ZG-untitled/fpga-environment-sound-recognition/mechanical/README.md

# Mechanical Files

- `enclosure/` contains the enclosure design note and six panel models in 3MF and STL formats, supplied by teammate C.
- `microphone_plate/` contains the microphone plate generator and the supplied STL exports.
- `../docs/images/interface/interface.png` is the supplied interface screenshot.

The 3MF files are editable slicer/project files; STL files are mesh exports for inspection or printing. Confirm fit and print settings against the physical board and screen before manufacturing.
