ZG-untitled/fpga-environment-sound-recognition/mechanical/enclosure/外壳设计方案.md

# 作品外壳设计方案（六片分体版）

> 版本 v9（2026-10-29）· 丙（PS/整机负责人）
> 形态：**桌面横屏告警终端**，六片平放打印后拼装
> 本版替代并作废 v1「壁挂式 210×235×55」方案
>
> **v9 变更**：
> ① 屏幕开窗 **171×104 → 166×102**，位置 **z 8~110**。原来是"比玻璃大一圈"（左右缝 3.1、上下缝 2），
> 玻璃在窗口里晃、正面能看见缝隙；现在改成"**刚好托住玻璃**"：玻璃 164.8×100 距底座下边实测 **4.0**，
> 所以窗下沿放在 **z 8**，与玻璃下边**齐平**（窗下沿余料 2 → **4**），窗口横向只比玻璃大 **0.6**，
> 玻璃卡进窗孔、下边缘落在窗框上。副作用（正面收益）：4 个 Φ3.2 孔心 x 16.7 / 191.3
> 全部落到窗框后面，正看**不再露孔**。
> ② 灯带进线孔宽 3 → **4.5**（灯带端头是 **2.54-3P 杜邦胶壳**，厚 2.54~
> 2.6；原 3.0 单边仅余 0.23 mm，胶壳侧边锁扣再加一点就过不去）
>
> **v8 变更**：外廓 200→**208**（用户实测：串口屏排线从**屏幕左侧**引出，需侧向走线空间，
> 内腔留 200，模组 181 居中后左右净空各 9.5）；屏幕开窗 165.5×100.5 → **171×104**
> （横向受螺丝孔距 174.6 约束，上限 171.4，取 171 使 4×Φ3.2 孔全部被窗框挡住）；
> 后盖出口槽随右板内表面右移 8 → x 135~190
>
> v7：外廓 192→200；开窗 155×99 → 165.5×100.5；灯带进线孔 φ8 → 3×11 竖长方孔

---

## 一、器件尺寸（设计依据）

| 部件 | 尺寸（mm） | 说明 |
|---|---|---|
| 8 寸串口屏 8048AS048 | PCB 181×108（横放）；**LCD 模组 164.9×100（开窗依据）**；AA 154.08×85.92；厚 6.15；4×Φ3.2，孔距 **174.6 × 101.6** | 横放 |
| 启明星 ZYNQ-7020 底板 | **130×100**，板堆叠总高 **7.7**（含 1.6 PCB） | 平放 |
| INMP441 麦克风 | 4 只，2×2，孔距 **60×60**；沉孔 φ14.7×2.0 + 通孔 φ12.4 | 并入顶板 |
| WS2812 灯带 | **500 mm / 30 灯 / 宽 10** | 绕四周 |

---

## 二、总体尺寸

**208 (W) × 120 (D) × 140 (H)，壁厚 4，直角**

| 项 | 数值 |
|---|---|
| 内腔 | **192** × 112 × 132 |
| 屏幕模组 | 181 × 108，宽度方向居中（x 13.5~194.5），**底部贴底板内表面**（z 4~112）；玻璃 164.8×100 **距底座下边 4.0（实测）** → 落在 z 8~108，下边与窗下沿 z 8 齐平 |
| 屏幕窗 | **166 × 102**，x 21~187，z **8~110**（左右各留 21、下方 **4**、上方 26）；玻璃 164.8×100 距底座下边 4.0，下边与窗下沿齐平，横向缝 0.6 |
| 灯带槽 | z 121~132（宽 11）、深 1.5，绕前/后/左/右四周，中心线周长 **612** |
| 灯带进线孔 | **4.5(宽) × 11(高) 竖长方孔**，x 51.75~56.25，z 121~132，穿后壁 2.5，**距灯带左端头 3.75** |
| 麦克风 | 4×（沉孔 φ14.7 深 2 + 通孔 φ12.4），孔心 **(70,30)(130,30)(70,90)(130,90)** |
| 后盖出口 | 跑道形 55 × 20（R10），**x 135~190**，**z 12~32** |
| 开发板支撑 | M3 铜柱 **13**，DC 座插孔中心距箱底 **20**（实测） |
| 深度链 | 面板 4 + 屏 6.15 + 间隙 3.85 + 开发板 100 + 间隙 2 + 后盖 4 = 120 |

**为什么宽度是 208**：屏幕模组 181 宽横放，**排线从屏幕左侧引出**，左侧必须留出侧向走线空间。
内腔留 200（W=208），模组居中后左右净空各 **9.5**，左侧 9.5 足够 FPC 反折一次。
**为什么开窗是 166×102、z 8~110（v9 改小，不再"加大"）**：玻璃 164.8×100，模组 181×108。
窗口横向只比玻璃大 **0.6**，玻璃直接卡进窗孔 → 屏幕被窗框箍住不晃，正面缝隙从 3.1 降到 0.6。
三条硬约束同时满足：
① 螺丝孔 x 16.7 / 191.3（孔距 174.6）落在窗口 x 21~187 之外 → **不再露孔**
（v8 的 171 已刚好挡住，173 就会露出 0.8）；
② AA 区 154.08×85.92 距窗口边 5.96 / 8.04，**遮的只是黑边框，不切显示内容**；
③ **下沿与玻璃下边齐平**：玻璃距底座下边实测 **4.0**（模组 z 4~112 → 玻璃 z 8~108），
所以窗下沿放在 **z 8**，窗下沿余料 = 8 − 4 = **4**（v8 只有 2，用户指出太细）。
上沿 z 110 比玻璃上边 108 高 2，留装配余量。
（此前 v9 初稿把下沿放在 z 7、余 3，是因为把"4"只当成居中假设；用户拿卡尺在模型上量出 3 才纠正）

**为什么深度还是 120**：屏幕只占 6.15 厚，深度方向的约束来自开发板平放的 100 长 + DC 插头，与屏幕无关，故不动。

**为什么深度是 120**：开发板平放（不是立放）。立放时内高 132 只剩 2 mm 余量，而 DC 座那条边只能朝上、插头后 30 mm 硬护套无处可去，顶面又是麦克风板不能开槽——立放不可行。平放后插头从后盖孔穿出，硬护套留在壳外。

**DC 座高度决定铜柱**：实测插孔中心距箱底（放桌上即桌面）**20**。座体自身只能提供 7.1（PCB 顶面算起 5.5 + 板厚 1.6），所以铜柱必须垫到 **13**（M3×13 标准件）。

插头 φ12 占 z 14~26，JTAG 排线扭平后在其上方 z 28~31，故出口槽取 **z 12~32**：下端余 2、上端余 6。注意这是**偏心使用**——槽中心是 22，不是 20，高的那 6 mm 是留给排线的。

---

## 三、六片尺寸

| 片 | 外形（mm） | 内容 |
|---|---|---|
| `panel_front` 前面板 | **208** × 132 × 4 | 屏幕窗、灯带槽、上/下各 6 齿、左右竖棱舌槽 |
| `panel_back` 后面板 | **208** × 132 × 4 | 出口槽 55×20、灯带槽、上/下各 6 齿、竖棱舌槽 |
| `panel_left` 左板 | 4 × 112 × 132 | 灯带槽、上/下各 3 齿、前后两端伸舌 |
| `panel_right` 右板 | 4 × 112 × 132 | 同上（镜像） |
| `panel_top` 顶板 | **208** × 120 × 4 | 4×麦克风沉孔+通孔、18 个齿槽 |
| `panel_bottom` 底板 | **208** × 120 × 4 | 18 个齿槽 |

---

## 四、齿接参数

| 项 | 数值 | 说明 |
|---|---|---|
| 齿宽 | **7.8** | 槽 8.2，单边间隙 0.2 |
| 齿长 | **2.5** | 槽深 2.7，槽底留 1.3 料 |
| 前/后面板上下边 | 齿区**居中 96**，6 齿 | 两端各 48 平直 |
| 左/右板上边 | 齿区**居中 48**，3 齿 | 两端各 32 平直 |
| 竖棱 | 沿 Z **舌槽**，深 2 | z 10~110，避开灯带槽 |

**两条硬约束（不是省事）：**

1. **竖棱不能做齿。** 齿要咬合必须沿齿轴相对平移：前面板上齿齿轴是 Z（整板上下压），竖边齿轴是 X（整板左右移），一块板只有一条运动路线。所以竖棱只能是沿 Z 通长的舌槽，压入时顺槽滑合。

2. **齿长只能 2.5，不能 3.9。** 原本想让齿穿过 4 厚壁、外表面留 0.1 微凹。但 FDM 层高 0.2，0.1 的余量保不住，实际会顶穿或留缝。改 2.5/2.7 后槽底留 1.3，安全。

**为什么齿集中在中段**：指接不要求齿铺满整边，只要两片齿区对齐、其余平直段自然对上。集中后 ① 齿宽回到 7.8（铺满 192 会变成 17.5 的宽扁块）② 角部三面交角冲突自动消失 ③ 装配只需对准中段，抗打印误差。

---

## 五、装配顺序

1. **四墙沿 Z 拼合**：前面板 + 后面板平放定位，左板/右板沿 Z 滑入，舌进槽
2. **顶板从上压**：18 个齿槽同时套入四墙上齿
3. **翻面，底板压入**
4. 接缝点胶；灯带压在最上方接缝外侧补强

**注意**：顶板压合后基本不可拆。核心板、JTAG、SD 卡需在压合前操作完毕；调试期可先不上胶。

---

## 六、打印参数

**总原则：让每一片的所有凹槽"开口朝上"。** 开口朝上的槽是逐层向内收的坑，槽底直接落在已成型的实心材料上；开口朝下的槽是悬挑，只能靠桥接硬拉，必然下垂拉丝——这正是后盖舌槽粗糙的成因。

| 片 | 摆向 | 贴床面 | 凹槽开口 | 桥接 / 支撑 |
|---|---|---|---|---|
| 前面板 | 平放 | **内表面**（外表面朝上） | 灯带槽 11×1.5 朝上 ✓ | 仅竖棱舌槽 4 宽朝下，桥接 4 mm；**无支撑** |
| 左 / 右板 | 平放 | **内表面**（整面无槽） | 灯带槽 11×1.5 朝上 ✓ | **完全无桥接、无支撑** |
| 顶板 | 平放 | **外表面**（内表面朝上） | 18 个齿槽 8.2×2.7 朝上 ✓ | 沉孔朝下只剩 1.15 宽圆环桥接；**无支撑** |
| 底板 | 平放 | 外表面（已全平） | 18 个齿槽 8.2×2.7 朝上 ✓ | **完全无桥接、无支撑** |
| 后面板 | 已打印完成 | — | — | 不参与本轮 |

**为什么前面板/侧板从"外表面朝下"改成"内表面朝下"**：灯带槽开在外表面。外表面朝下时槽口朝下，槽底要跨 11 mm 悬空桥接；改内表面朝下，灯带槽口朝上，槽底变成实心支撑。代价仅是竖棱舌槽（4 宽）朝下桥接 4 mm，PLA 毫无压力。

**为什么顶板必须"外表面朝下"**：齿槽开在内表面。外表面朝上时 18 个齿槽开口朝下、槽底在 y=0 一端还没有锚点，是悬挑，会大面积下垂，18 个槽全部失准——这是本方案里唯一不能妥协的一处。代价是白色顶面贴床（得纹理面）＋沉孔口需象脚补偿。

**切片参数（已写入 5 个 3mf）**

| 参数 | 旧 | 新 | 原因 |
|---|---|---|---|
| 稀疏填充密度 | 15% | **100%** | 4 mm 板只有 20 层，15% 网格在 4 mm 宽的槽下根本生成不出填充，槽底是悬在空腔上的桥接 → 坑洼（后盖实拍） |
| 壁数 | 2 | **3** | 齿根要抗压合 |
| 顶/底实心层 | 5 / 3 | **6 / 6** | 与全实心一致，边缘更整 |
| brim | auto | **outer_brim 5 mm** | 192×137 大薄板防翘；打完用刀沿边划一圈 |
| 象脚补偿 | 默认 0.15 | **0.2** | 顶板沉孔口贴床，补偿后 φ14.7 才能塞进模块 |

- 层高 0.2（性价比最佳点，不再降）；材料 PLA（白色前面板 + 顶板、黑色其余四片）
- 全实心后材料约 **413 g**（5 片合计 332.9 cm³），4 盘、约 15~18 小时
- 齿的配合间隙靠打印精度，首件试装后可用砂纸微调

**排盘（256×256 床，含 5 mm brim 后的实际占位）**

| 盘 | 颜色 | 件 | 占位 |
|---|---|---|---|
| 1 | 白 | 前面板 | 202 × 147 |
| 2 | 白 | 顶板 | 202 × 130 |
| 3 | 黑 | 底板 + 左板 | 202 × 246 |
| 4 | 黑 | 右板 | 147 × 126 |

白片两件叠放差 1 mm 放不下（137+120+brim > 256），所以白色必须分两盘。

### 黑白双色

| 件 | 颜色 | 理由 |
|---|---|---|
| 前面板 | **白** | 屏幕四周留白形成相框；白壁对灯带漫反射更柔，不刺眼 |
| 顶板 | **白** | 与前面板构成连续 L 形白壳，顶面不是"黑盖子"；四个沉孔成为白盘嵌黑心的阵列，看得出是麦克风；白顶面反射室内光，整机显亮 |
| 底 / 左 / 右 / 后 | **黑** | 深色围边收住白色主面，黑白交界在竖棱上，接缝被色差掩盖 |

白色总用量 37.6 + 95.7 = **133.3 cm³**；黑色 101.1 + 98.0 + 59.4×2 = **317.9 cm³**，六片合计 **451.2 cm³ ≈ 560 g**。（左右板几何与 W 无关，可复用已打的那对；重打 front/back/top/bottom 四片合计 332.4 cm³ ≈ **412 g**）

**代价（已接受）**：白 PLA 顶面是最易受光、积灰的面，长期会轻微黄变；且为了齿槽不塌，顶板必须外表面贴床打印，白色顶面会带 PEI 床纹（哑光磨砂质感，不影响使用）。

---

## 七、已知取舍

| 取舍 | 原因 |
|---|---|
| **取消四角 R8 圆角** | 六片拼接，圆角在接缝处会不一致、出现台阶；直角更干净，打印后可砂纸倒棱 |
| 齿长 2.5 而非 3.9 | FDM 精度，见上 |
| 平直段无互锁 | 靠胶，长度：前/后板各 4×48、侧板各 4×32 |
| 屏幕不打螺丝 | 4 个 Φ3.2 孔（孔距 174.6×101.6）正落在 11 宽灯带槽后方，槽深 3 后只剩 1 mm，无处做 M3 柱。改面板内侧 3M 泡棉胶 + 底部坐内底承重。**v9 起窗框还能当止口用**：玻璃卡进 166×102 窗孔、下边缘与窗下沿齐平，横向贴合面 7.5 宽、纵向 4 宽（下沿），胶贴在这圈上 |
| 灯带缺口 80 留在背面 | 槽周长 580、灯带 500，差 80。背面朝墙，从正面看不见；缺口同时是进线处 |

### 灯带走线

槽中心线周长 = 2×((208−11)+(120−11)) = **612**，灯带 500，**背面中段空槽 112**（x 48~160）。

**装配时灯带从缺口左端（x=48）起头**，绕前 → 右 → 背面 → 左一周，另一端落在缺口右端（x=160）。两段背面可见长度各 66.5。

进线孔 **4.5(宽)×11(高) 的竖长方孔开在缺口左端、距端头 3.75 mm 处（x 51.75~56.25, z 121~132）**，与灯带槽同高、把槽底整条打穿，穿过后壁剩余的 2.5 mm 进入内腔。

**孔宽 4.5 的来历**：灯带端头是 **2.54-3P 杜邦胶壳**，实测规格 **7.62(长边) × 2.54~2.6(厚) × 14(沿穿孔方向)**。
三根线从灯带端头并排出来，胶壳的长边 7.62 自然沿槽高（Z）方向，厚度 2.54 沿 X 方向——所以必须开**竖长口**。
孔宽若取 3.0（v7/v8），单边只剩 0.23 mm，胶壳侧边的锁扣凸起再加 0.1~0.2、FDM 收缩 0.1，
基本就是过不去或硬怼进去；取 **4.5** 后单边余 **0.98**，可以顺穿。孔高 11 对应胶壳 7.62，单边余 1.69，本来就富余。
胶壳沿穿孔方向长 14，穿过 4 厚的板后整段落在箱内（该处内腔 z 121~132 是空的），不影响穿孔尺寸。

**为什么不用圆孔**：φ8 圆孔在 1.5 深的槽底只能开成月牙，实际通光只有 5×2，胶壳根本过不去。竖长口与槽同高、开口向上完全敞开，线从焊点出来先上翻进槽、再直接下穿，不别劲。

**为什么贴端头而不是开在缺口中央**：灯带焊点就在端头，线沿长度方向伸出，距孔只有 4.5 mm，一个向下的弯就进去了。若开在中央，线要在深 1.5 的槽里横走 40 mm，三根线带热缩管会鼓出槽面。

装配注意：**灯带有线的一端必须放在缺口左端**，否则孔对不上线头。

灯珠 1.6 高、FPC 0.2，槽深 1.5，灯珠外露 0.3，可以接受。

---

## 八、仍待实测

1. **DC 座中心到板右边缘**（估 11）—— 决定出口槽在 x 向的位置
2. **JTAG 座中心到板后沿**（估 39）—— 决定出口槽长度够不够
3. 屏幕接口是排针还是 FPC、横放后在 PCB 哪条边 —— 决定走线孔

前两项决定出口槽位置（当前按估值 11/39 开），第三项决定走线孔。**z 向已实测：DC 座中心距箱底 20，已落地。**

---

## 九、产物

- `gen_panels.py` —— 参数化生成脚本（trimesh + manifold3d 布尔）
- `panel_front.stl` / `panel_back.stl` / `panel_left.stl` / `panel_right.stl` / `panel_top.stl` / `panel_bottom.stl`
- 六片均 watertight，两两无相交；装配总包围盒 **208 × 120 × 140**；材料合计 **447.9 cm³ ≈ 555 g**（占外形 12.8%）
- 各片体积：front 34.19 / back 101.19 / left 59.36 / right 59.36 / top 95.73 / bottom 98.05 cm³
- `fix_3mf_flat.py` —— 第一轮（v6）：平放贴床 + 黑白配色
- `fix_3mf_print.py` —— 第二轮（v6）：凹槽开口朝上 + 100% 全实心
- `rebuild_3mf.py` —— **v7**：用新 STL 重建前/后/顶/底四片的 3mf 几何（保留打印参数），
  姿态统一为「外表面朝上」；右板只改 `source_offset_x`（几何未变）
- 主目录六个 `.3mf` = 六片成品，可直接打印：
  front(白) / back(黑) / left(黑) / right(黑) / top(白) / bottom(黑)
- 打印参数（六片统一）：**100% zig-zag / 墙 3 / 顶底 6-6 / auto_brim / 象脚补偿 0.2**
  （bottom 为用户手改版：5-3 层；六片均已补 0.2 象脚）
- 姿态：front / back / left / right 外表面朝上（灯带槽开口向上，悬空 10.00 / 10.00 / 0 / 0 cm²）；
  top / bottom 外表面朝下（top 仅麦克风沉孔环 1.95 cm²，可正常打印）
- 备份：`_stl_v6_backup/`（v6 的 STL）、`_3mf_v6_backup/`（v6 的 3mf 与旧 192 版后面板）、
  `_3mf_backup_20261028/`（最原始导出件）
- 注：STL 用**装配坐标**（板厚沿 Y 或 X），直接导入切片会立起来；3mf 里已转平并居中到 128 板
