ZG-untitled/fpga-environment-sound-recognition/THIRD_PARTY_NOTICES.md

# Third-party notices

本仓库的团队原创源代码、脚本和文档按 `LICENSE` 中的 MIT License 提供。以下内容仍遵循其原始许可和使用条款：

- AMD/Xilinx Vivado、Vitis、Zynq-7000 Processing System、FFT、ILA、AXI 等工具或 IP 生成内容；
- INMP441、WS2812、陶晶驰串口屏等器件的商标、数据手册和协议；
- 模型训练中使用的公开数据集及其原始许可证，详见模型目录中的许可文件；
- Python、NumPy、PyTorch 等开发依赖。
