ZG-untitled/fpga-environment-sound-recognition/mechanical/enclosure/panel_left.3mf

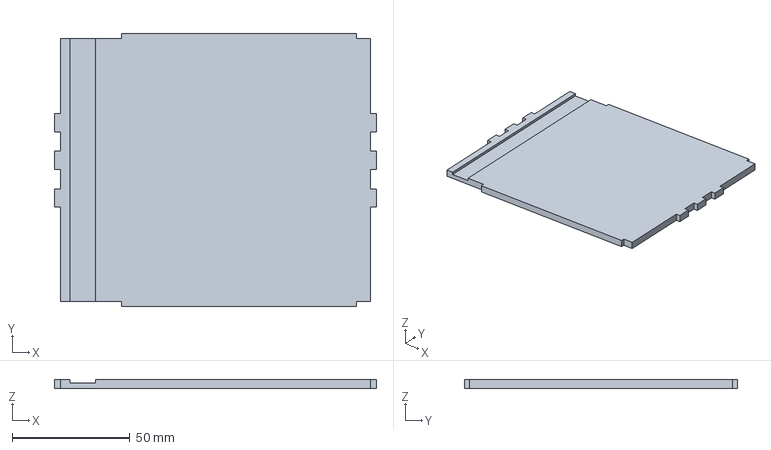
[picture p10: CAD file, 2026-11-04]
mechanical/enclosure/panel_left.3mf
137.0 x 116.0 x 4.00 mm
