ZG-untitled/fpga-environment-sound-recognition/mechanical/microphone_plate/mic_plate_v2.stl

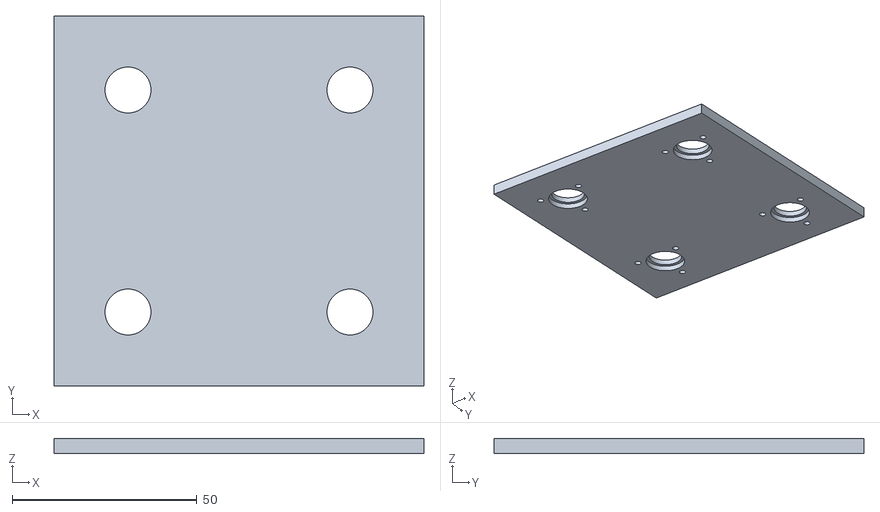
[picture p11: CAD file, 2026-11-04]
mechanical/microphone_plate/mic_plate_v2.stl
100.0 x 100.0 x 4.00
