ZG-untitled/fpga-environment-sound-recognition/mechanical/enclosure/panel_top.3mf

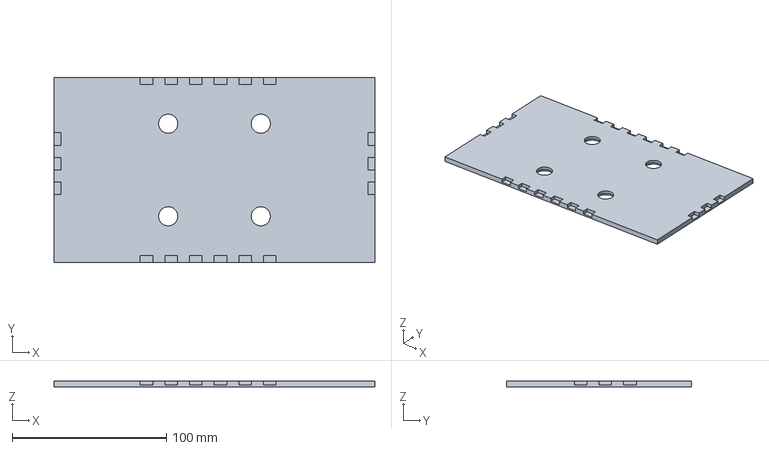
[picture p12: CAD file, 2026-11-04]
mechanical/enclosure/panel_top.3mf
208.0 x 120.0 x 4.00 mm
