ZG-untitled/fpga-environment-sound-recognition/mechanical/microphone_plate/mic_cap_v1.stl

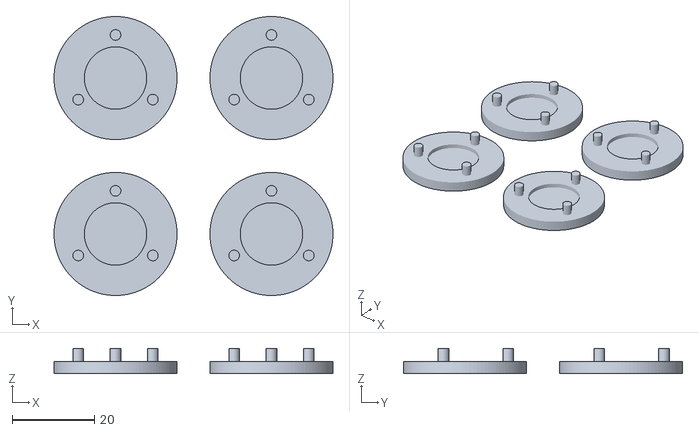
[picture p13: CAD file, 2026-11-04]
mechanical/microphone_plate/mic_cap_v1.stl
68.0 x 68.0 x 6.20
