ZG-untitled/fpga-environment-sound-recognition/mechanical/enclosure/panel_front.3mf

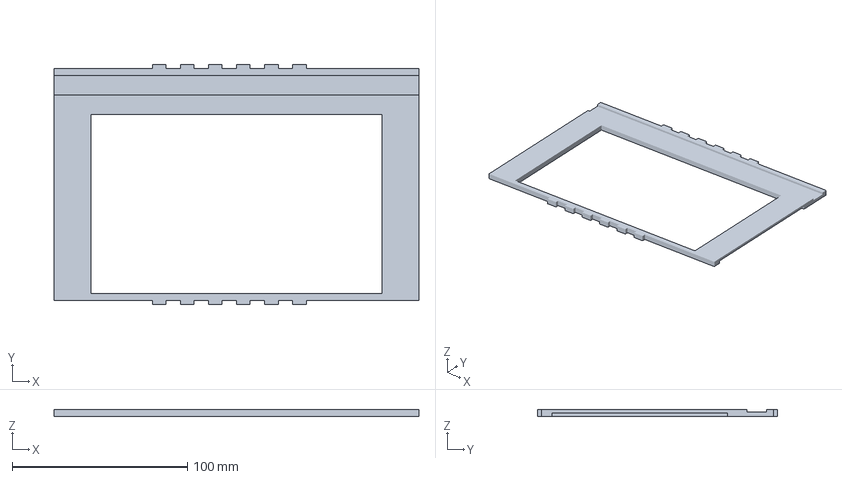
[picture p14: CAD file, 2026-11-04]
mechanical/enclosure/panel_front.3mf
208.0 x 137.0 x 4.00 mm
