ZG-untitled/fpga-environment-sound-recognition/(list of files, cad)

Other CAD files:
mechanical/enclosure/panel_bottom.3mf
mechanical/enclosure/panel_right.3mf
mechanical/enclosure/panel_back.stl
mechanical/enclosure/panel_bottom.stl
mechanical/enclosure/panel_front.stl
mechanical/enclosure/panel_left.stl
mechanical/enclosure/panel_right.stl
mechanical/enclosure/panel_top.stl
