ZG-untitled/fpga-environment-sound-recognition/(commit log)

2026-11-04 上传项目 v1
    [acceptance_results.csv, cards.csv, fp32_confusion.csv, host_regression.csv, int8_confusion.csv, metrics.csv, mic_cap_v1.stl, mic_plate_v2.stl]
2026-11-04 删除提示语
    Removed a warning about not including personal information in the repository.
2026-11-04 修改语言
