ZG-untitled/fpga-environment-sound-recognition/(notices)

Notices in the files:
README.md:
License: MIT
